LookMumFlyingCan/CanSat/KiCad2/Envboard/envboard/envboard.kicad_pcb

## KiCad design KiCad2/Envboard/envboard/envboard.kicad_pcb (2020-12-16)

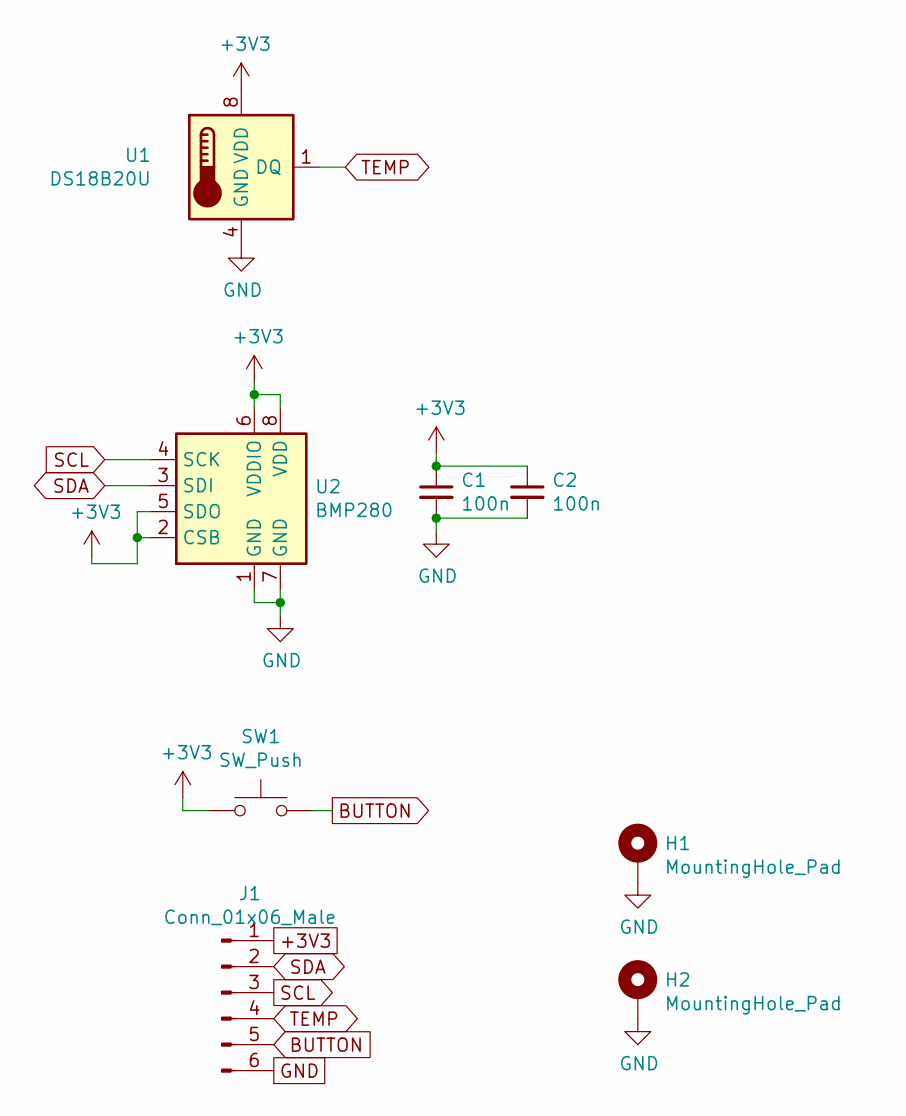
[picture p1: schematic envboard.sch]

Parts:
C1, C2: 100n; C_0603_1608Metric
H1, H2: MountingHole_Pad; MountingHole_2.2mm_M2_Pad_Via
J1: Conn_01x06_Male; JST_SH_BM06B-SRSS-TB_1x06-1MP_P1.00mm_Vertical
SW1: SW_Push; SW_SPST_TAEF-25R-V-T
U1: DS18B20U; MSOP-8_3x3mm_P0.65mm
U2: BMP280; Bosch_LGA-8_2x2.5mm_P0.65mm_ClockwisePinNumbering

Connections:
+3V3: C1.1, C2.1, J1.1, SW1.1, U1.8 (VDD), U2.2 (CSB), U2.5 (SDO), U2.6 (VDDIO), U2.8 (VDD)
BUTTON: J1.5, SW1.2
GND: C1.2, C2.2, H1.1, H2.1, J1.6, U1.4 (GND), U2.1 (GND), U2.7 (GND)
SCL: J1.3, U2.4 (SCK)
SDA: J1.2, U2.3 (SDI)
TEMP: J1.4, U1.1 (DQ)

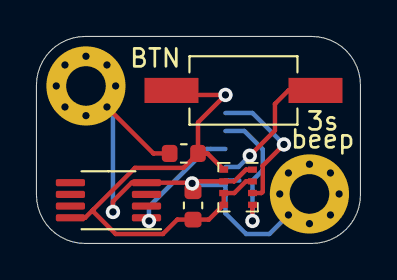
[picture p2: board envboard.kicad_pcb from above]

Board: 2 copper layers, 18.0 x 11.5 mm, 8 parts (1 on the bottom side), 6 nets.
