LookMumFlyingCan/CanSat/KiCad/CanSat.kicad_pcb

## KiCad design KiCad/CanSat.kicad_pcb (2020-12-16)

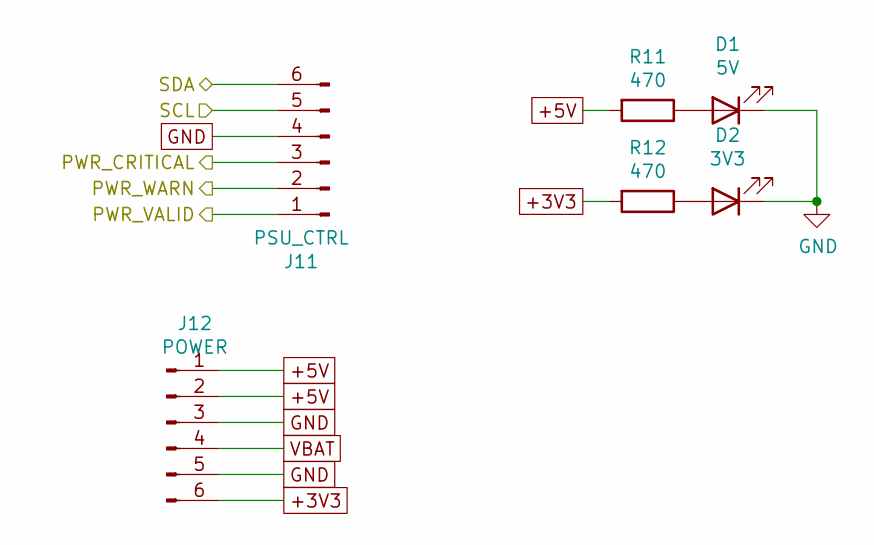
[picture p3: schematic power.sch, Power Conditioning Section]

Parts:
D1: 5V; LED_0603_1608Metric_Pad1.05x0.95mm_HandSolder
D2: 3V3; LED_0603_1608Metric_Pad1.05x0.95mm_HandSolder
J11: PSU_CTRL; JST_SH_SM06B-SRSS-TB_1x06-1MP_P1.00mm_Horizontal
J12: POWER; JST_PH_S6B-PH-K_1x06_P2.00mm_Horizontal
R11, R12: 470; R_0603_1608Metric_Pad1.05x0.95mm_HandSolder

Connections:
+5V: J12.1, J12.2, R11.2; also elsewhere on the board
/Peripherals and Connectors/SCL: J11.5; also elsewhere on the board
/Peripherals and Connectors/SDA: J11.6; also elsewhere on the board
/Power/PWR_CRITICAL: J11.3; also elsewhere on the board
/Power/PWR_VALID: J11.1; also elsewhere on the board
/Power/PWR_WARN: J11.2; also elsewhere on the board
GND: D1.1 (K), D2.1 (K), J11.4, J12.3, J12.5; also elsewhere on the board
unnamed: D1.2 (A), R11.1
unnamed: D2.2 (A), R12.1
VBAT: J12.4; also elsewhere on the board

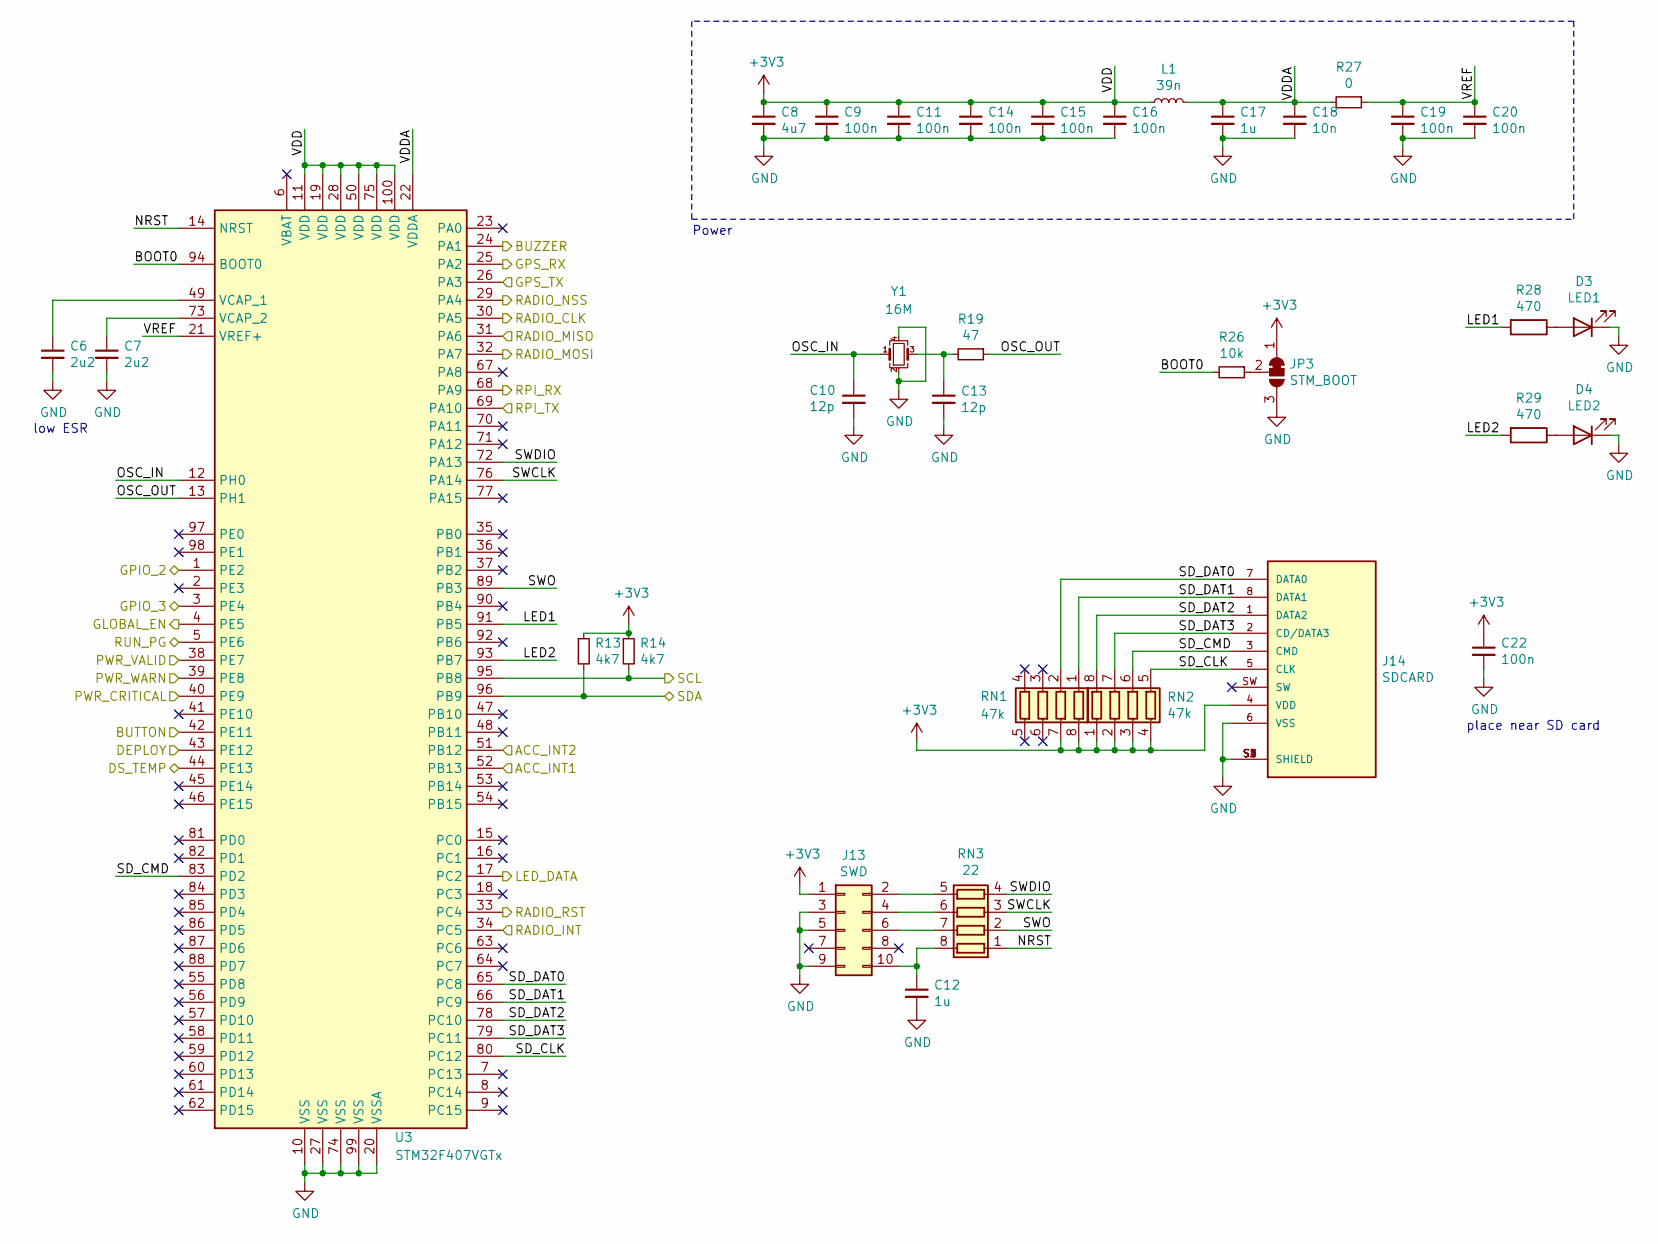
[picture p4: schematic mcu.sch, STM32F4 MCU Section]

Parts:
C6, C7: 2u2; C_0603_1608Metric_Pad1.05x0.95mm_HandSolder
C8: 4u7; C_0603_1608Metric_Pad1.05x0.95mm_HandSolder
C9, C11, C14, C15, C16, C19, C20, C22: 100n; C_0603_1608Metric_Pad1.05x0.95mm_HandSolder
C10, C13: 12p; C_0603_1608Metric_Pad1.05x0.95mm_HandSolder
C12, C17: 1u; C_0603_1608Metric_Pad1.05x0.95mm_HandSolder
C18: 10n; C_0603_1608Metric_Pad1.05x0.95mm_HandSolder
D3: LED1; LED_0603_1608Metric_Pad1.05x0.95mm_HandSolder
D4: LED2; LED_0603_1608Metric_Pad1.05x0.95mm_HandSolder
J13: SWD; PinHeader_2x05_P1.27mm_Vertical_SMD
J14: SDCARD; MOLEX_47352-1001; PARTREV K
JP3: STM_BOOT; SolderJumper-3_P1.3mm_Bridged12_RoundedPad1.0x1.5mm
L1: 39n; L_0603_1608Metric_Pad1.05x0.95mm_HandSolder
R13, R14: 4k7; R_0603_1608Metric_Pad1.05x0.95mm_HandSolder
R19: 47; R_0603_1608Metric_Pad1.05x0.95mm_HandSolder
R26: 10k; R_0603_1608Metric_Pad1.05x0.95mm_HandSolder
R27: 0; R_0805_2012Metric_Pad1.15x1.40mm_HandSolder
R28, R29: 470; R_0603_1608Metric_Pad1.05x0.95mm_HandSolder
RN1, RN2: 47k; R_Array_Concave_4x0603
RN3: 22; R_Array_Concave_4x0603
U3: STM32F407VGTx; LQFP-100_14x14mm_P0.5mm
Y1: 16M; Crystal_SMD_3225-4Pin_3.2x2.5mm_HandSoldering

Connections:
/Peripherals and Connectors/ACC_INT1: U3.52 (PB13); also elsewhere on the board
/Peripherals and Connectors/ACC_INT2: U3.51 (PB12); also elsewhere on the board
/Peripherals and Connectors/BUTTON: U3.42 (PE11); also elsewhere on the board
/Peripherals and Connectors/BUZZER: U3.24 (PA1); also elsewhere on the board
/Peripherals and Connectors/DEPLOY: U3.43 (PE12); also elsewhere on the board
/Peripherals and Connectors/DS_EXTERNAL: U3.44 (PE13); also elsewhere on the board
/Peripherals and Connectors/GPIO_2: U3.1 (PE2); also elsewhere on the board
/Peripherals and Connectors/GPIO_3: U3.3 (PE4); also elsewhere on the board
/Peripherals and Connectors/GPS_RX: U3.25 (PA2); also elsewhere on the board
/Peripherals and Connectors/GPS_TX: U3.26 (PA3); also elsewhere on the board
/Peripherals and Connectors/LED_DATA: U3.17 (PC2); also elsewhere on the board
/Peripherals and Connectors/RADIO_CLK: U3.30 (PA5); also elsewhere on the board
/Peripherals and Connectors/RADIO_INT: U3.34 (PC5); also elsewhere on the board
/Peripherals and Connectors/RADIO_MISO: U3.31 (PA6); also elsewhere on the board
/Peripherals and Connectors/RADIO_MOSI: U3.32 (PA7); also elsewhere on the board
/Peripherals and Connectors/RADIO_NSS: U3.29 (PA4); also elsewhere on the board
/Peripherals and Connectors/RADIO_RST: U3.33 (PC4); also elsewhere on the board
/Peripherals and Connectors/SCL: R14.2, U3.95 (PB8); also elsewhere on the board
/Peripherals and Connectors/SDA: R13.2, U3.96 (PB9); also elsewhere on the board
/Power/PWR_CRITICAL: U3.40 (PE9); also elsewhere on the board
/Power/PWR_VALID: U3.38 (PE7); also elsewhere on the board
/Power/PWR_WARN: U3.39 (PE8); also elsewhere on the board
/RPi CM4/GLOBAL_EN: U3.4 (PE5); also elsewhere on the board
/RPi CM4/RPI_RX: U3.68 (PA9); also elsewhere on the board
/RPi CM4/RPI_TX: U3.69 (PA10); also elsewhere on the board
/RPi CM4/RUN_PG: U3.5 (PE6); also elsewhere on the board
/STM32 MCU/BOOT0: R26.2, U3.94 (BOOT0)
/STM32 MCU/LED1: R28.2, U3.91 (PB5)
/STM32 MCU/LED2: R29.2, U3.93 (PB7)
/STM32 MCU/NRST: RN3.1 (R1.1), U3.14 (NRST)
/STM32 MCU/OSC_IN: C10.1, U3.12 (PH0), Y1.1
/STM32 MCU/OSC_OUT: R19.1, U3.13 (PH1)
/STM32 MCU/SD_CLK: J14.5 (CLK), RN2.5 (R4.2), U3.80 (PC12)
/STM32 MCU/SD_CMD: J14.3 (CMD), RN2.6 (R3.2), U3.83 (PD2)
/STM32 MCU/SD_DAT0: J14.7 (DATA0), RN1.2 (R2.1), U3.65 (PC8)
/STM32 MCU/SD_DAT1: J14.8 (DATA1), RN1.1 (R1.1), U3.66 (PC9)
/STM32 MCU/SD_DAT2: J14.1 (DATA2), RN2.8 (R1.2), U3.78 (PC10)
/STM32 MCU/SD_DAT3: J14.2 (CD/DATA3), RN2.7 (R2.2), U3.79 (PC11)
/STM32 MCU/SWCLK: RN3.3 (R3.1), U3.76 (PA14)
/STM32 MCU/SWDIO: RN3.4 (R4.1), U3.72 (PA13)
/STM32 MCU/SWO: RN3.2 (R2.1), U3.89 (PB3)
/STM32 MCU/VDDA: C17.1, C18.1, L1.2, R27.2, U3.22 (VDDA)
/STM32 MCU/VREF: C19.1, C20.1, R27.1, U3.21 (VREF+)
GND: C6.2, C7.2, C8.2, C9.2, C10.2, C11.2, C12.2, C13.2, C14.2, C15.2, C16.2, C17.2, C18.2, C19.2, C20.2, C22.2, D3.1 (K), D4.1 (K), J13.3, J13.5, J13.9, J14.6 (VSS), J14.S1 (SHIELD), J14.S2 (SHIELD), J14.S3 (SHIELD), J14.S4 (SHIELD), JP3.3 (B), U3.10 (VSS), U3.20 (VSSA), U3.27 (VSS), U3.74 (VSS), U3.99 (VSS), Y1.2, Y1.4; also elsewhere on the board
unnamed: C6.1, U3.49 (VCAP_1)
unnamed: C7.1, U3.73 (VCAP_2)
unnamed: C12.1, J13.10, RN3.8 (R1.2)
unnamed: C13.1, R19.2, Y1.3
unnamed: D3.2 (A), R28.1
unnamed: D4.2 (A), R29.1
unnamed: J13.2, RN3.5 (R4.2)
unnamed: J13.4, RN3.6 (R3.2)
unnamed: J13.6, RN3.7 (R2.2)
unnamed: JP3.2 (C), R26.1

Notes on the sheet:
low ESR
Power
place near SD card

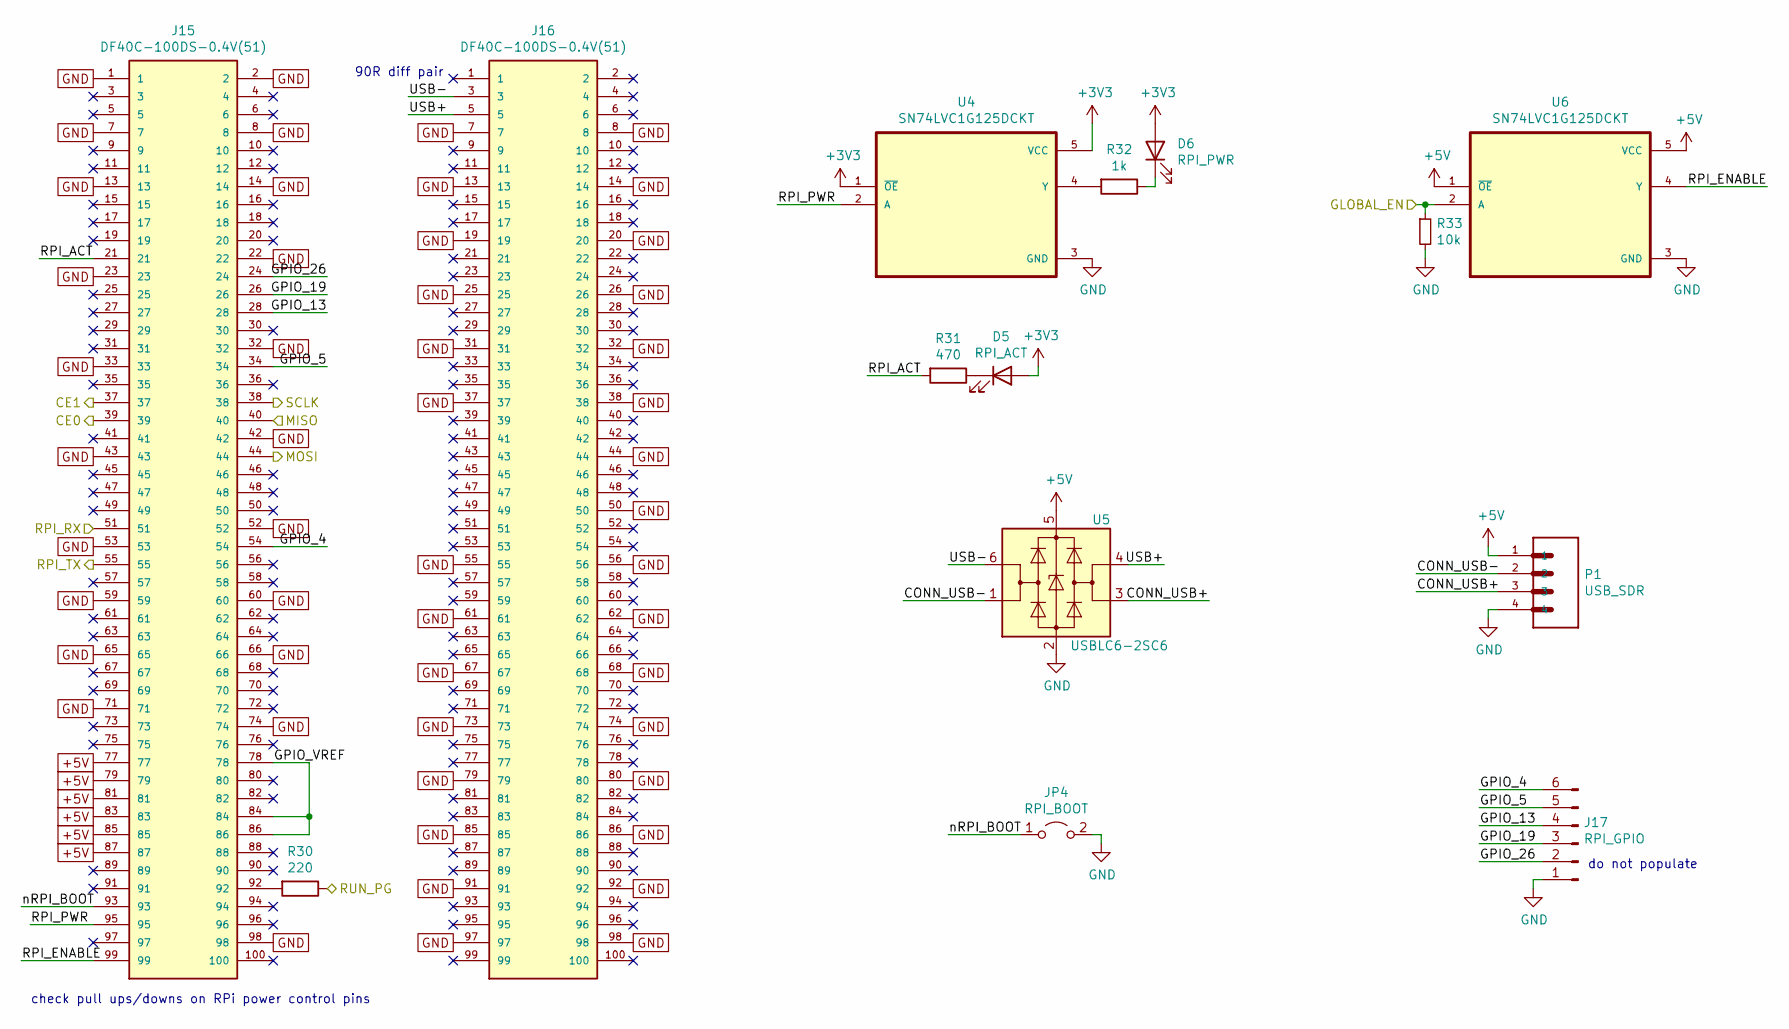
[picture p5: schematic rpi_cm4.sch, RPi Compute Module 4 Section]

Parts:
D5: RPI_ACT; LED_0603_1608Metric_Pad1.05x0.95mm_HandSolder
D6: RPI_PWR; LED_0603_1608Metric_Pad1.05x0.95mm_HandSolder
J15, J16: DF40C-100DS-0.4V(51); HRS_DF40C-100DS-0.4V(51)
J17: RPI_GPIO; PinHeader_1x06_P1.00mm_Vertical
JP4: RPI_BOOT; TestPoint_2Pads_Pitch2.54mm_Drill0.8mm
P1: USB_SDR; TE_1734366-1
R30: 220; R_0603_1608Metric_Pad1.05x0.95mm_HandSolder
R31: 470; R_0603_1608Metric_Pad1.05x0.95mm_HandSolder
R32: 1k; R_0603_1608Metric_Pad1.05x0.95mm_HandSolder
R33: 10k; R_0603_1608Metric_Pad1.05x0.95mm_HandSolder
U4, U6: SN74LVC1G125DCKT; SOT65P210X110-5N
U5: USBLC6-2SC6; SOT-23-6

Connections:
+5V: J15.77, J15.79, J15.81, J15.83, J15.85, J15.87, P1.1, U5.5 (VBUS), U6.1 (~OE), U6.5 (VCC); also elsewhere on the board
/Peripherals and Connectors/CLK: J15.38; also elsewhere on the board
/Peripherals and Connectors/MISO: J15.40; also elsewhere on the board
/Peripherals and Connectors/MOSI: J15.44; also elsewhere on the board
/RPi CM4/CE0: J15.39; also elsewhere on the board
/RPi CM4/CE1: J15.37; also elsewhere on the board
/RPi CM4/CONN_USB+: P1.3, U5.3 (I/O2)
/RPi CM4/CONN_USB-: P1.2, U5.1 (I/O1)
/RPi CM4/GLOBAL_EN: R33.1, U6.2 (A); also elsewhere on the board
/RPi CM4/GPIO_4: J15.54, J17.6
/RPi CM4/GPIO_5: J15.34, J17.5
/RPi CM4/GPIO_13: J15.28, J17.4
/RPi CM4/GPIO_19: J15.26, J17.3
/RPi CM4/GPIO_26: J15.24, J17.2
/RPi CM4/GPIO_VREF: J15.78, J15.84, J15.86
/RPi CM4/RPI_ACT: J15.21, R31.2
/RPi CM4/RPI_ENABLE: J15.99, U6.4 (Y)
/RPi CM4/RPI_PWR: J15.95, U4.2 (A)
/RPi CM4/RPI_RX: J15.51; also elsewhere on the board
/RPi CM4/RPI_TX: J15.55; also elsewhere on the board
/RPi CM4/RUN_PG: R30.1; also elsewhere on the board
/RPi CM4/USB+: J16.5, U5.4 (I/O2)
/RPi CM4/USB-: J16.3, U5.6 (I/O1)
/RPi CM4/nRPI_BOOT: J15.93, JP4.1 (A)
GND: J15.1, J15.2, J15.7, J15.8, J15.13, J15.14, J15.22, J15.23, J15.32, J15.33, J15.42, J15.43, J15.52, J15.53, J15.59, J15.60, J15.65, J15.66, J15.71, J15.74, J15.98, J16.7, J16.8, J16.13, J16.14, J16.19, J16.20, J16.25, J16.26, J16.31, J16.32, J16.37, J16.38, J16.44, J16.50, J16.55, J16.56, J16.61, J16.62, J16.67, J16.68, J16.73, J16.74, J16.79, J16.80, J16.85, J16.86, J16.91, J16.92, J16.97, J16.98, J17.1, JP4.2 (B), P1.4, R33.2, U4.3 (GND), U5.2 (GND), U6.3 (GND); also elsewhere on the board
unnamed: D5.1 (K), R31.1
unnamed: D6.1 (K), R32.1
unnamed: J15.92, R30.2
unnamed: R32.2, U4.4 (Y)

Notes on the sheet:
90R diff pair
check pull ups/downs on RPi power control pins
do not populate

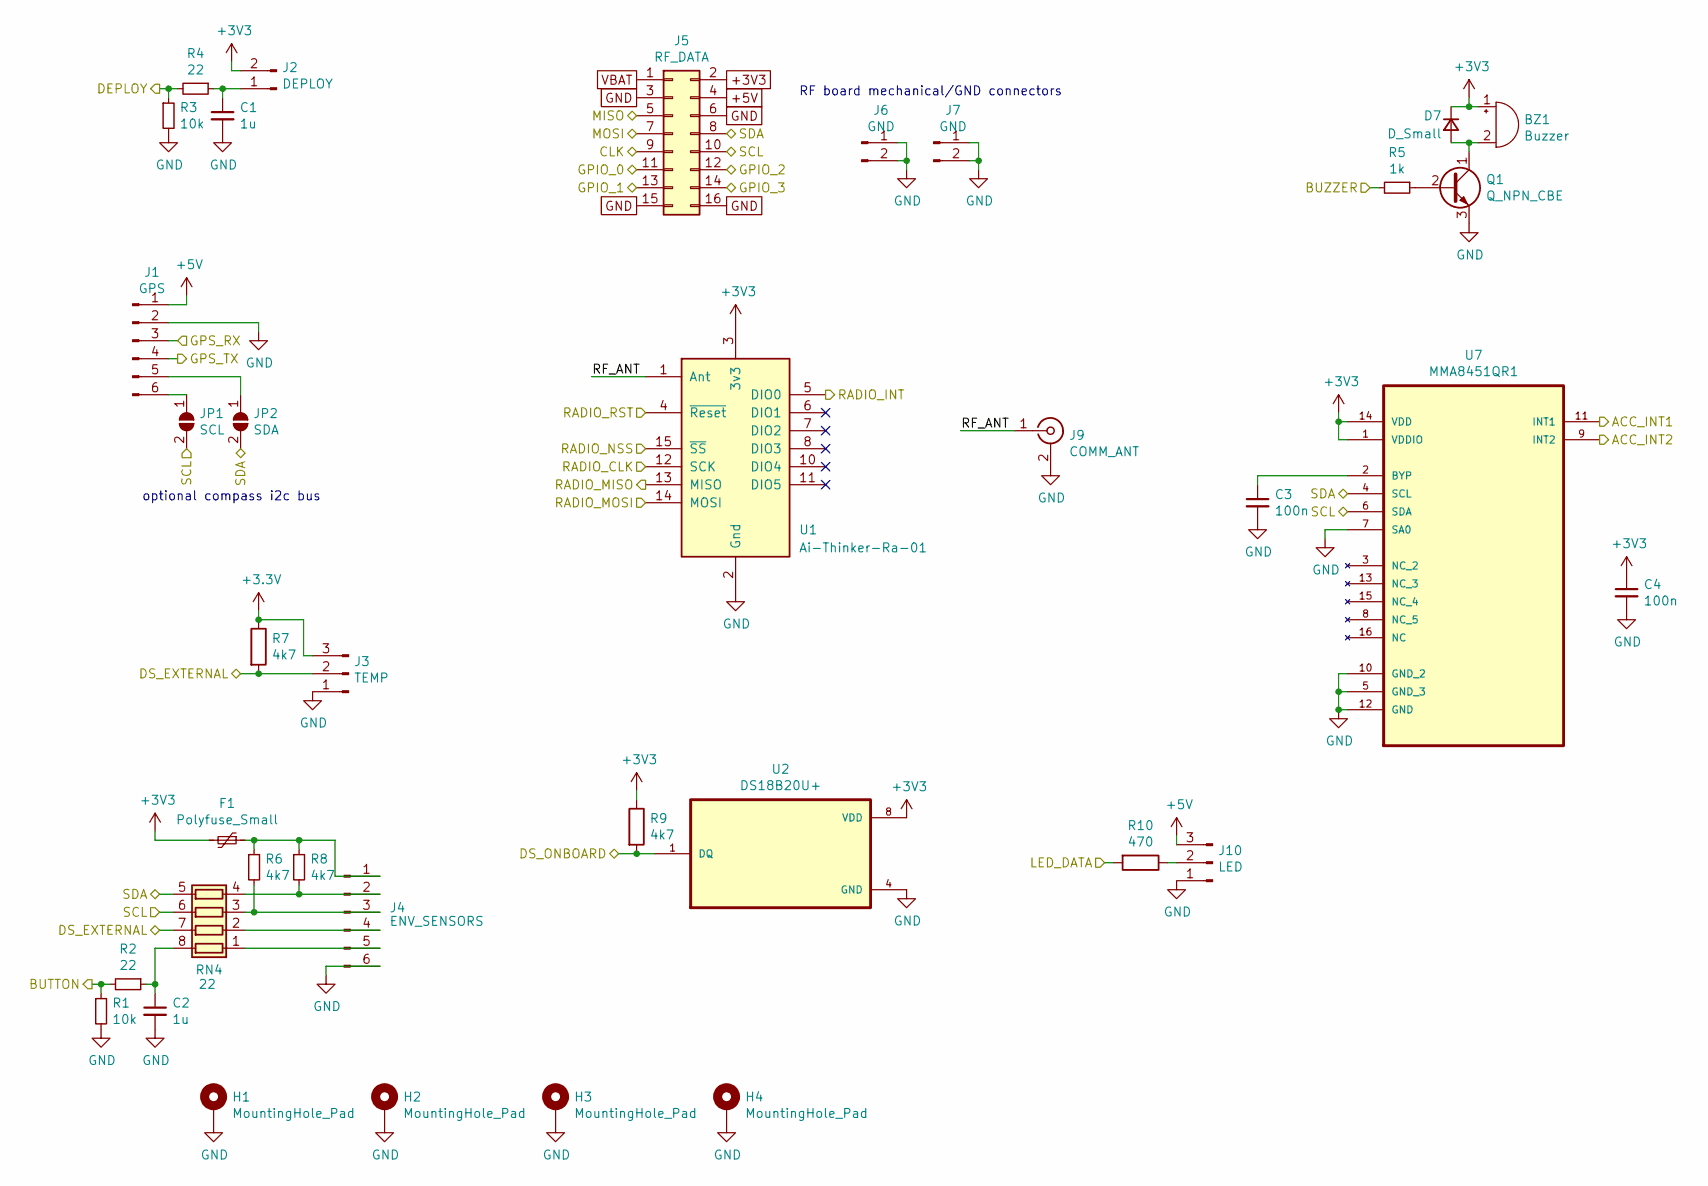
[picture p6: schematic perpherals.sch, Peripherals and Connectors Section]

Parts:
BZ1: Buzzer; MagneticBuzzer_INGHAi_GSC4417YA-16R4000
C1, C2: 1u; C_0603_1608Metric_Pad1.05x0.95mm_HandSolder
C3, C4: 100n; C_0603_1608Metric_Pad1.05x0.95mm_HandSolder
D7: D_Small; D_0603_1608Metric_Pad1.05x0.95mm_HandSolder
F1: Polyfuse_Small; Fuse_0603_1608Metric_Pad1.05x0.95mm_HandSolder
H1, H2, H3, H4: MountingHole_Pad; MountingHole_2.7mm_M2.5_Pad_Via
J1: GPS; JST_SH_SM06B-SRSS-TB_1x06-1MP_P1.00mm_Horizontal
J2: DEPLOY; JST_SH_SM02B-SRSS-TB_1x02-1MP_P1.00mm_Horizontal
J3: TEMP; JST_SH_SM03B-SRSS-TB_1x03-1MP_P1.00mm_Horizontal
J4: ENV_SENSORS; JST_SH_SM06B-SRSS-TB_1x06-1MP_P1.00mm_Horizontal
J5: RF_DATA; PinHeader_2x08_P1.27mm_Vertical_SMD
J6, J7: GND; PinHeader_1x02_P2.54mm_Vertical
J9: COMM_ANT; U.FL_Molex_MCRF_73412-0110_Vertical
J10: LED; PinHeader_1x03_P2.54mm_Horizontal
JP1: SCL; SolderJumper-2_P1.3mm_Open_TrianglePad1.0x1.5mm
JP2: SDA; SolderJumper-2_P1.3mm_Open_TrianglePad1.0x1.5mm
Q1: Q_NPN_CBE; SOT-23
R1, R3: 10k; R_0603_1608Metric_Pad1.05x0.95mm_HandSolder
R2, R4: 22; R_0603_1608Metric_Pad1.05x0.95mm_HandSolder
R5: 1k; R_0603_1608Metric_Pad1.05x0.95mm_HandSolder
R6, R7, R8, R9: 4k7; R_0603_1608Metric_Pad1.05x0.95mm_HandSolder
R10: 470; R_0603_1608Metric_Pad1.05x0.95mm_HandSolder
RN4: 22; R_Array_Concave_4x0603
U1: Ai-Thinker-Ra-01; Ai-Thinker-Ra-01-LoRa
U2: DS18B20U+; SOP65P490X110-8N
U7: MMA8451QR1; QFN50P300X300X100-16N; MPN MMA8451QR1

Connections:
+5V: J1.1, J5.4, J10.3; also elsewhere on the board
/Peripherals and Connectors/ACC_INT1: U7.11 (INT1); also elsewhere on the board
/Peripherals and Connectors/ACC_INT2: U7.9 (INT2); also elsewhere on the board
/Peripherals and Connectors/BUTTON: R1.1, R2.2; also elsewhere on the board
/Peripherals and Connectors/BUZZER: R5.2; also elsewhere on the board
/Peripherals and Connectors/CLK: J5.9; also elsewhere on the board
/Peripherals and Connectors/DEPLOY: R3.1, R4.2; also elsewhere on the board
/Peripherals and Connectors/DS_EXTERNAL: J3.2, R7.2, R9.2, RN4.7 (R2.2), U2.1 (DQ); also elsewhere on the board
/Peripherals and Connectors/GPIO_2: J5.12; also elsewhere on the board
/Peripherals and Connectors/GPIO_3: J5.14; also elsewhere on the board
/Peripherals and Connectors/GPS_RX: J1.3; also elsewhere on the board
/Peripherals and Connectors/GPS_TX: J1.4; also elsewhere on the board
/Peripherals and Connectors/LED_DATA: R10.2; also elsewhere on the board
/Peripherals and Connectors/MISO: J5.5; also elsewhere on the board
/Peripherals and Connectors/MOSI: J5.7; also elsewhere on the board
/Peripherals and Connectors/RADIO_CLK: U1.12 (SCK); also elsewhere on the board
/Peripherals and Connectors/RADIO_INT: U1.5 (DIO0); also elsewhere on the board
/Peripherals and Connectors/RADIO_MISO: U1.13 (MISO); also elsewhere on the board
/Peripherals and Connectors/RADIO_MOSI: U1.14 (MOSI); also elsewhere on the board
/Peripherals and Connectors/RADIO_NSS: U1.15 (~SS); also elsewhere on the board
/Peripherals and Connectors/RADIO_RST: U1.4 (~Reset); also elsewhere on the board
/Peripherals and Connectors/RF_ANT: J9.1 (In), U1.1 (Ant)
/Peripherals and Connectors/SCL: J5.10, JP1.2 (B), RN4.6 (R3.2), U7.6 (SDA); also elsewhere on the board
/Peripherals and Connectors/SDA: J5.8, JP2.2 (B), RN4.5 (R4.2), U7.4 (SCL); also elsewhere on the board
/RPi CM4/CE0: J5.11; also elsewhere on the board
/RPi CM4/CE1: J5.13; also elsewhere on the board
GND: C1.2, C2.2, C3.2, C4.2, H1.1, H2.1, H3.1, H4.1, J1.2, J3.1, J4.6, J5.3, J5.6, J5.15, J5.16, J6.1, J6.2, J7.1, J7.2, J9.2 (Ext), J10.1, Q1.3 (E), R1.2, R3.2, U1.2 (Gnd), U1.9 (Gnd), U1.16 (Gnd), U2.4 (GND), U7.5 (GND_3), U7.7 (SA0), U7.10 (GND_2), U7.12 (GND); also elsewhere on the board
unnamed: BZ1.2 (+), D7.2 (A), Q1.1 (C)
unnamed: C1.1, J2.1, R4.1
unnamed: C2.1, R2.1, RN4.8 (R1.2)
unnamed: C3.1, U7.2 (BYP)
unnamed: F1.1, J4.1, R6.1, R8.1
unnamed: J1.5, JP2.1 (A)
unnamed: J1.6, JP1.1 (A)
unnamed: J4.2, R8.2, RN4.4 (R4.1)
unnamed: J4.3, R6.2, RN4.3 (R3.1)
unnamed: J4.4, RN4.2 (R2.1)
unnamed: J4.5, RN4.1 (R1.1)
unnamed: J10.2, R10.1
unnamed: Q1.2 (B), R5.1
VBAT: J5.1; also elsewhere on the board

Notes on the sheet:
optional compass i2c bus
RF board mechanical/GND connectors

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
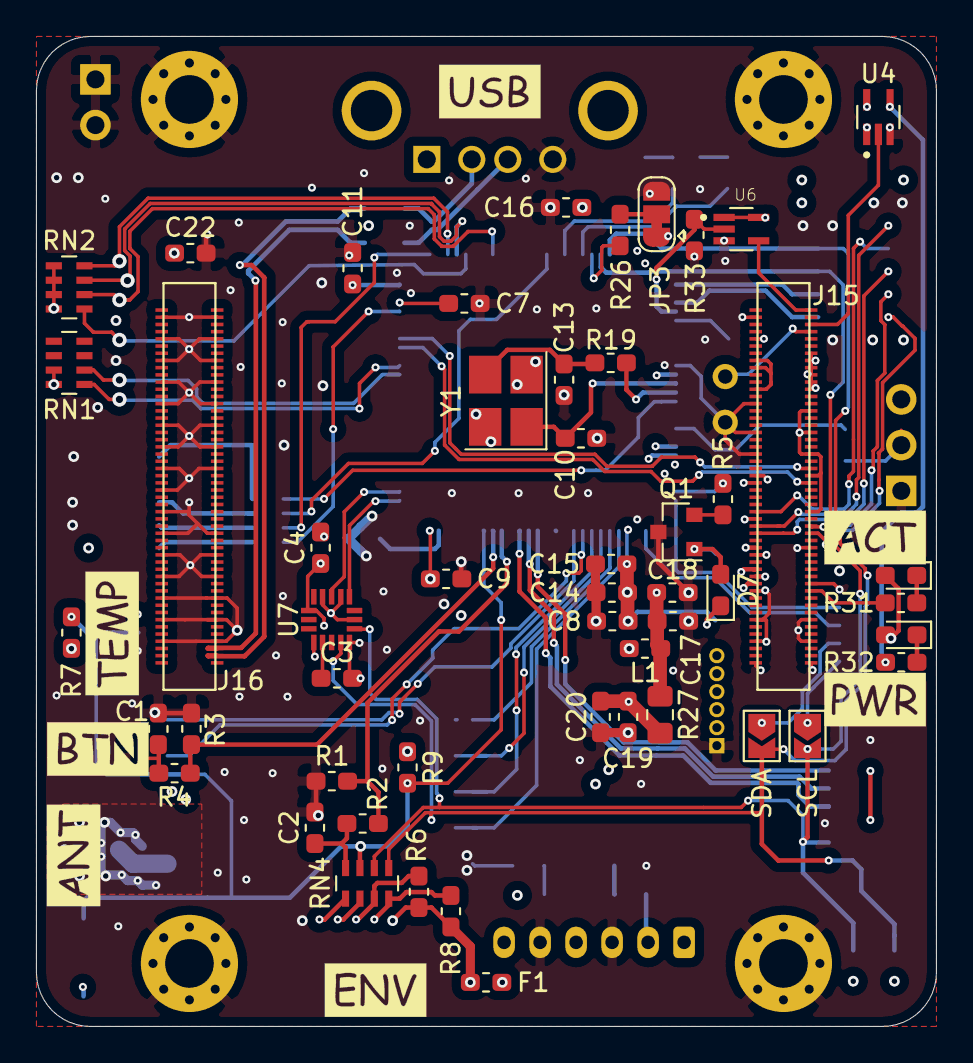
[picture p7: board CanSat.kicad_pcb from above]

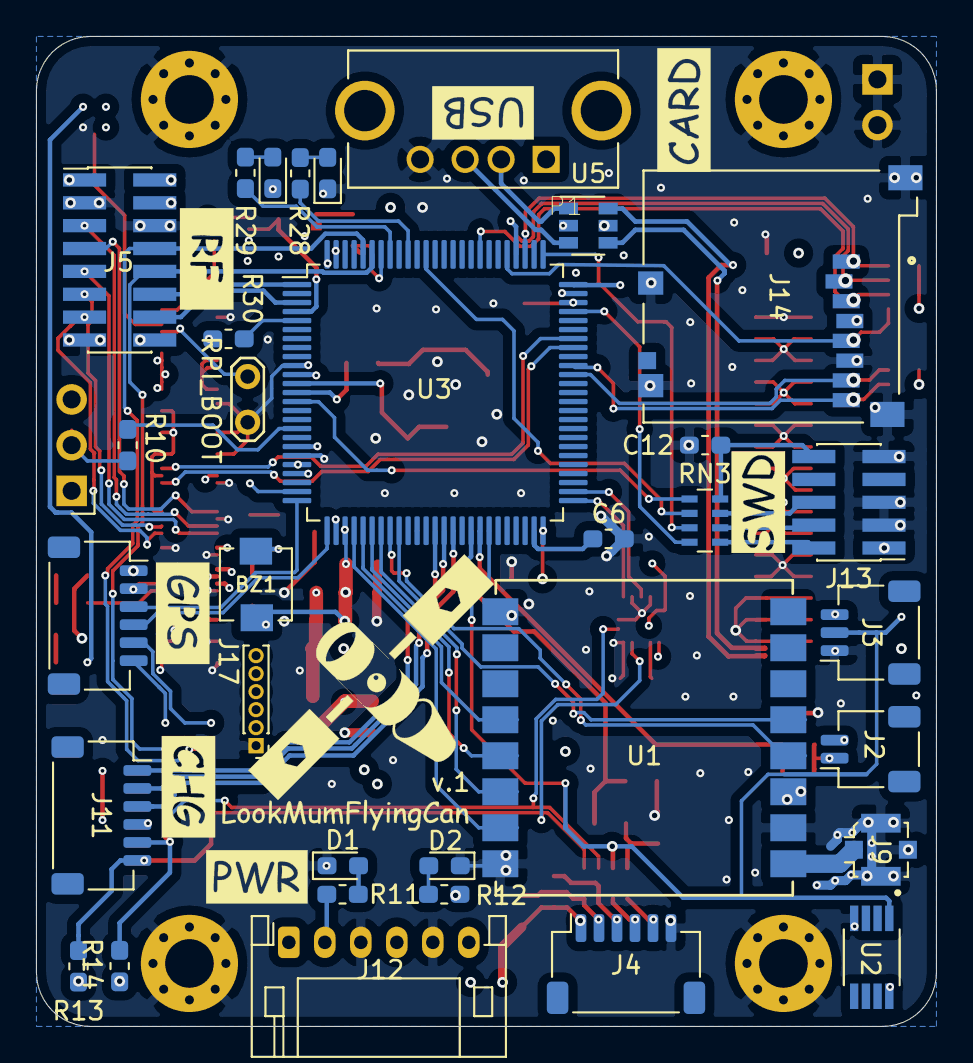
[picture p8: board CanSat.kicad_pcb from below]

Board: 4 copper layers, 50.0 x 55.0 mm, 90 parts (34 on the bottom side), 96 nets.
