LookMumFlyingCan/CanSat/KiCad2/BMS/bms.kicad_pcb

## KiCad design KiCad2/BMS/bms.kicad_pcb (2020-12-16)

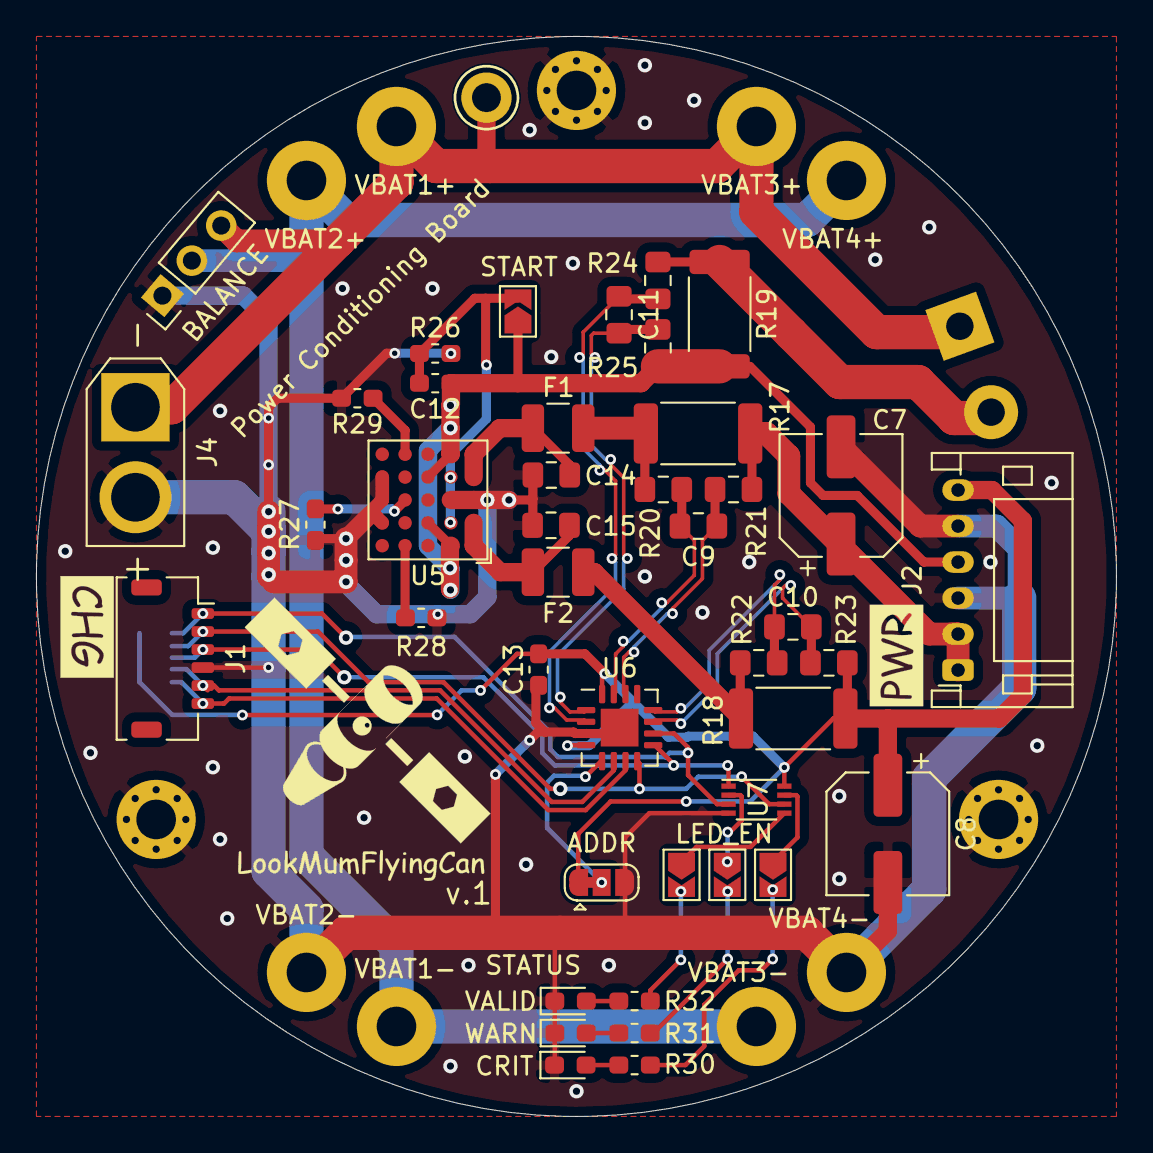
[picture p9: board bms.kicad_pcb from above]

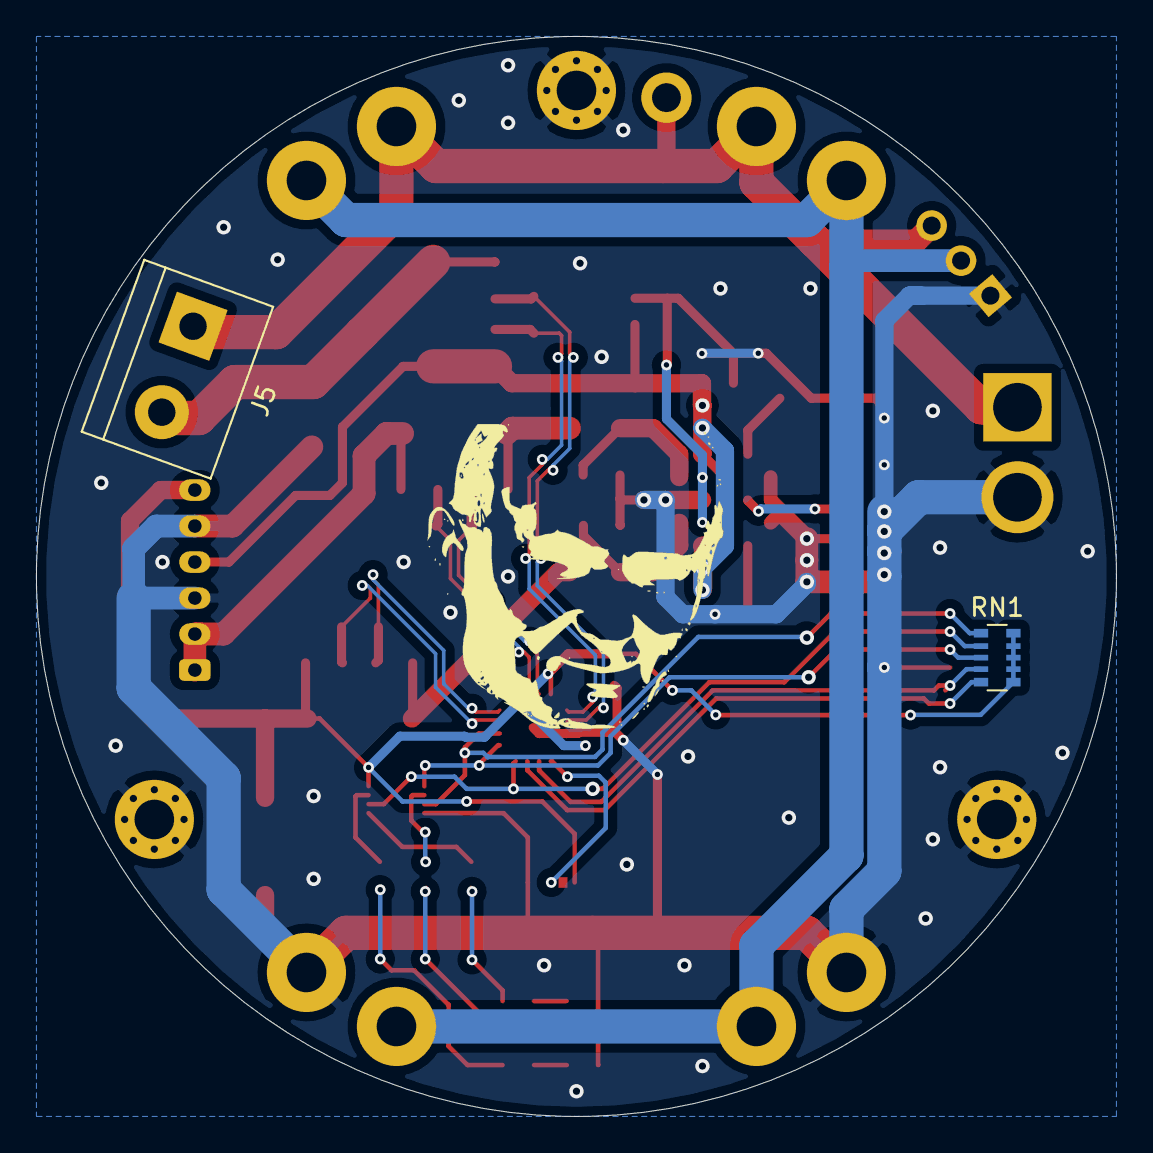
[picture p10: board bms.kicad_pcb from below]

Board: 2 copper layers, 60.0 x 60.0 mm, 56 parts (2 on the bottom side), 36 nets.

Parts:
ADDR: A0; SolderJumper-3_P1.3mm_Bridged12_RoundedPad1.0x1.5mm
BALANCE: BALANCE; PinHeader_1x03_P2.54mm_Vertical
C7, C8: 150u; CP_Elec_6.3x5.8
C9, C10, C11: 500p; C_0805_2012Metric_Pad1.15x1.40mm_HandSolder
C12: 10u; C_0603_1608Metric_Pad1.05x0.95mm_HandSolder
C13: 100n; C_0603_1608Metric_Pad1.05x0.95mm_HandSolder
C14, C15: 10u; C_0805_2012Metric_Pad1.15x1.40mm_HandSolder
CRIT: DIGITAL_CRITICAL; LED_0603_1608Metric_Pad1.05x0.95mm_HandSolder
F1, F2: 1210L150/16WR; Fuse_1210_3225Metric
H9, H11: MountingHole; MountingHole_2.2mm_M2_Pad_Via
He: MountingHole; MountingHole_2.2mm_M2_Pad_Via
J1: PSU_CTRL; JST_SHL_SM06B-SHLS-TF_1x06-1MP_P1.00mm_Horizontal
J2: PWR; JST_PH_S6B-PH-K_1x06_P2.00mm_Horizontal
J4: CHARGE; AMASS_XT30U-F_1x02_P5.0mm_Vertical
J5: PWR; TerminalBlock_bornier-2_P5.08mm
JP3, JP4, JP5: SolderJumper_2_Open; SolderJumper-2_P1.3mm_Open_TrianglePad1.0x1.5mm
R17: 0.05; R_2512_6332Metric
R18, R19: 0.08; R_2512_6332Metric
R20, R21, R22, R23, R24, R25: 5; R_0805_2012Metric_Pad1.15x1.40mm_HandSolder
R26: 47k; R_0603_1608Metric_Pad1.05x0.95mm_HandSolder
R27: 215k; R_0603_1608Metric_Pad1.05x0.95mm_HandSolder
R28: 13k3; R_0603_1608Metric_Pad1.05x0.95mm_HandSolder
R29: 8k25; R_0603_1608Metric_Pad1.05x0.95mm_HandSolder
R30, R31: 1k; R_0603_1608Metric_Pad1.05x0.95mm_HandSolder
R32: 470; R_0603_1608Metric_Pad1.05x0.95mm_HandSolder
RN1: R_Pack05; R_Array_Convex_5x0603
START: 0; SolderJumper-2_P1.3mm_Open_TrianglePad1.0x1.5mm
TP1: +BATT; TestPoint_Keystone_5010-5014_Multipurpose
U5: LTM4622EYPBF; BGA-25_6.35x6.35mm_Layout5x5_P1.27mm
U6: INA3221; Texas_RGV_S-PVQFN-N16_EP2.1x2.1mm
U7: 74LVC3G04; VSSOP-8_2.3x2mm_P0.5mm
VALID: DIGITAL_PV; LED_0603_1608Metric_Pad1.05x0.95mm_HandSolder
VBAT1+: VBAT1+; MountingHole_2.2mm_M2_Pad
VBAT1-: VBAT1-; MountingHole_2.2mm_M2_Pad
VBAT2+: VBAT2+; MountingHole_2.2mm_M2_Pad
VBAT2-: VBAT2-; MountingHole_2.2mm_M2_Pad
VBAT3+: VBAT3+; MountingHole_2.2mm_M2_Pad
VBAT3-: VBAT3-; MountingHole_2.2mm_M2_Pad
VBAT4+: VBAT4+; MountingHole_2.2mm_M2_Pad
VBAT4-: VBAT4-; MountingHole_2.2mm_M2_Pad
WARN: DIGITAL_WARNING; LED_0603_1608Metric_Pad1.05x0.95mm_HandSolder

Connections:
+3V3: ADDR.1, C8.1, C13.1, J2.6, R18.2, R23.2, RN1.6, RN1.7, RN1.8, RN1.9, RN1.10, U6.4, U6.16, U7.8
+5V: C7.1, J2.1, J2.2, R17.2, R21.2
+BATT: BALANCE.3, J4.1, J5.1, TP1.1, VBAT1+.1, VBAT3+.1
A0: ADDR.2, U6.5
BAT: C12.1, J2.4, R19.2, R25.2, START.1, U5.A2, U5.B3, U5.D3, U5.E2
GND: ADDR.3, BALANCE.1, C7.2, C8.2, C13.2, C14.2, C15.2, CRIT.1, H9.1, H11.1, He.1, J1.4, J2.3, J2.5, J4.2, R26.2, R27.1, R28.2, R29.2, U5.B5, U5.C1, U5.C2, U5.C5, U5.D5, U6.3, U6.17, U7.4, VALID.1, VBAT2-.1, VBAT4-.1, WARN.1
IN1+: C10.1, R22.1, U6.12
IN1-: C10.2, R23.1, U6.11
IN2+: C9.1, R20.1, U6.15
IN2-: C9.2, R21.1, U6.14
IN3+: C11.1, R24.1, U6.2
IN3-: C11.2, R25.1, U6.1
LTM_3V3: F2.1, R18.1, R22.2
LTM_5V: F1.1, R17.1, R20.2
unnamed: C12.2, R26.1, START.2, U5.B2, U5.D2
unnamed: C14.1, F1.2, U5.D1, U5.E1
unnamed: C15.1, F2.2, U5.A1, U5.B1
unnamed: CRIT.2, R30.1
unnamed: R31.1, WARN.2
unnamed: R32.1, VALID.2
unnamed: J5.2, R19.1, R24.2
unnamed: JP3.1, U7.7
unnamed: JP3.2, R30.2
unnamed: JP4.1, U7.2
unnamed: JP4.2, R31.2
unnamed: JP5.1, U7.5
unnamed: JP5.2, R32.2
unnamed: R27.2, U5.C4
unnamed: R28.1, U5.A4
unnamed: R29.1, U5.E4
PWR_CRITICAL: J1.3, RN1.3, U6.9, U7.1
PWR_VALID: J1.1, RN1.1, U6.10, U7.3
PWR_WARN: J1.2, RN1.2, U6.8, U7.6
SCL: J1.5, RN1.4, U6.6
SDA: J1.6, RN1.5, U6.7
VBAT1-: BALANCE.2, VBAT1-.1, VBAT2+.1, VBAT3-.1, VBAT4+.1
