LookMumFlyingCan/CanSat/(commit log)

2020-12-04 WIP KiCad Flight Computer Schematic
    [CanSat.kicad_pcb, CanSat.sch, mcu.sch, peripherals.sch, perpherals.sch, power.sch, rpi_cm4.sch]
2020-12-04 Update schematic
    [CanSat.sch, mcu.sch, perpherals.sch, rpi_cm4.sch]
2020-12-06 Finalized schematic and created S/F associations
    [CanSat.sch, mcu.sch, perpherals.sch, power.sch, rpi_cm4.sch]
2020-12-07 Done some stuff
    [mcu.sch, perpherals.sch, power.sch]
2020-12-07 FC PCB components layout
    [CanSat.kicad_pcb, mcu.sch]
2020-12-09 Semi-final flight computer version
    [CanSat-B_Cu.gbr, CanSat-B_Mask.gbr, CanSat-B_Paste.gbr, CanSat-B_SilkS.gbr, CanSat-Edge_Cuts.gbr, CanSat-F_Cu.gbr, CanSat-F_Mask.gbr, CanSat-F_Paste.gbr]
2020-12-11 Updated page labels
    [CanSat.kicad_pcb, CanSat.sch, mcu.sch, perpherals.sch, power.sch, rpi_cm4.sch]
2020-12-11 Added a button and a buzzer
    [CanSat.kicad_pcb, CanSat.sch, mcu.sch, perpherals.sch, power.sch]
2020-12-12 Change all SH connectors to horizontal
    [CanSat.kicad_pcb, perpherals.sch, power.sch]
2020-12-16 Dirty production PCBs commit
    [CanSat-B_Cu.gbr, CanSat-B_Mask.gbr, CanSat-B_Paste.gbr, CanSat-B_SilkS.gbr, CanSat-Edge_Cuts.gbr, CanSat-F_Cu.gbr, CanSat-F_Mask.gbr, CanSat-F_Paste.gbr]
2020-12-16 Update .gitignore for KiCad
    [CanSat-NPTH.drl, CanSat-PTH.drl, bms-NPTH.drl, bms-PTH.drl, envboard-NPTH.drl, envboard-PTH.drl]
